Mikekim67/kicad/bp6a_evk_shield/bp6a_evk_shield.kicad_sch

## KiCad design bp6a_evk_shield/bp6a_evk_shield.kicad_sch (2025-01-07)

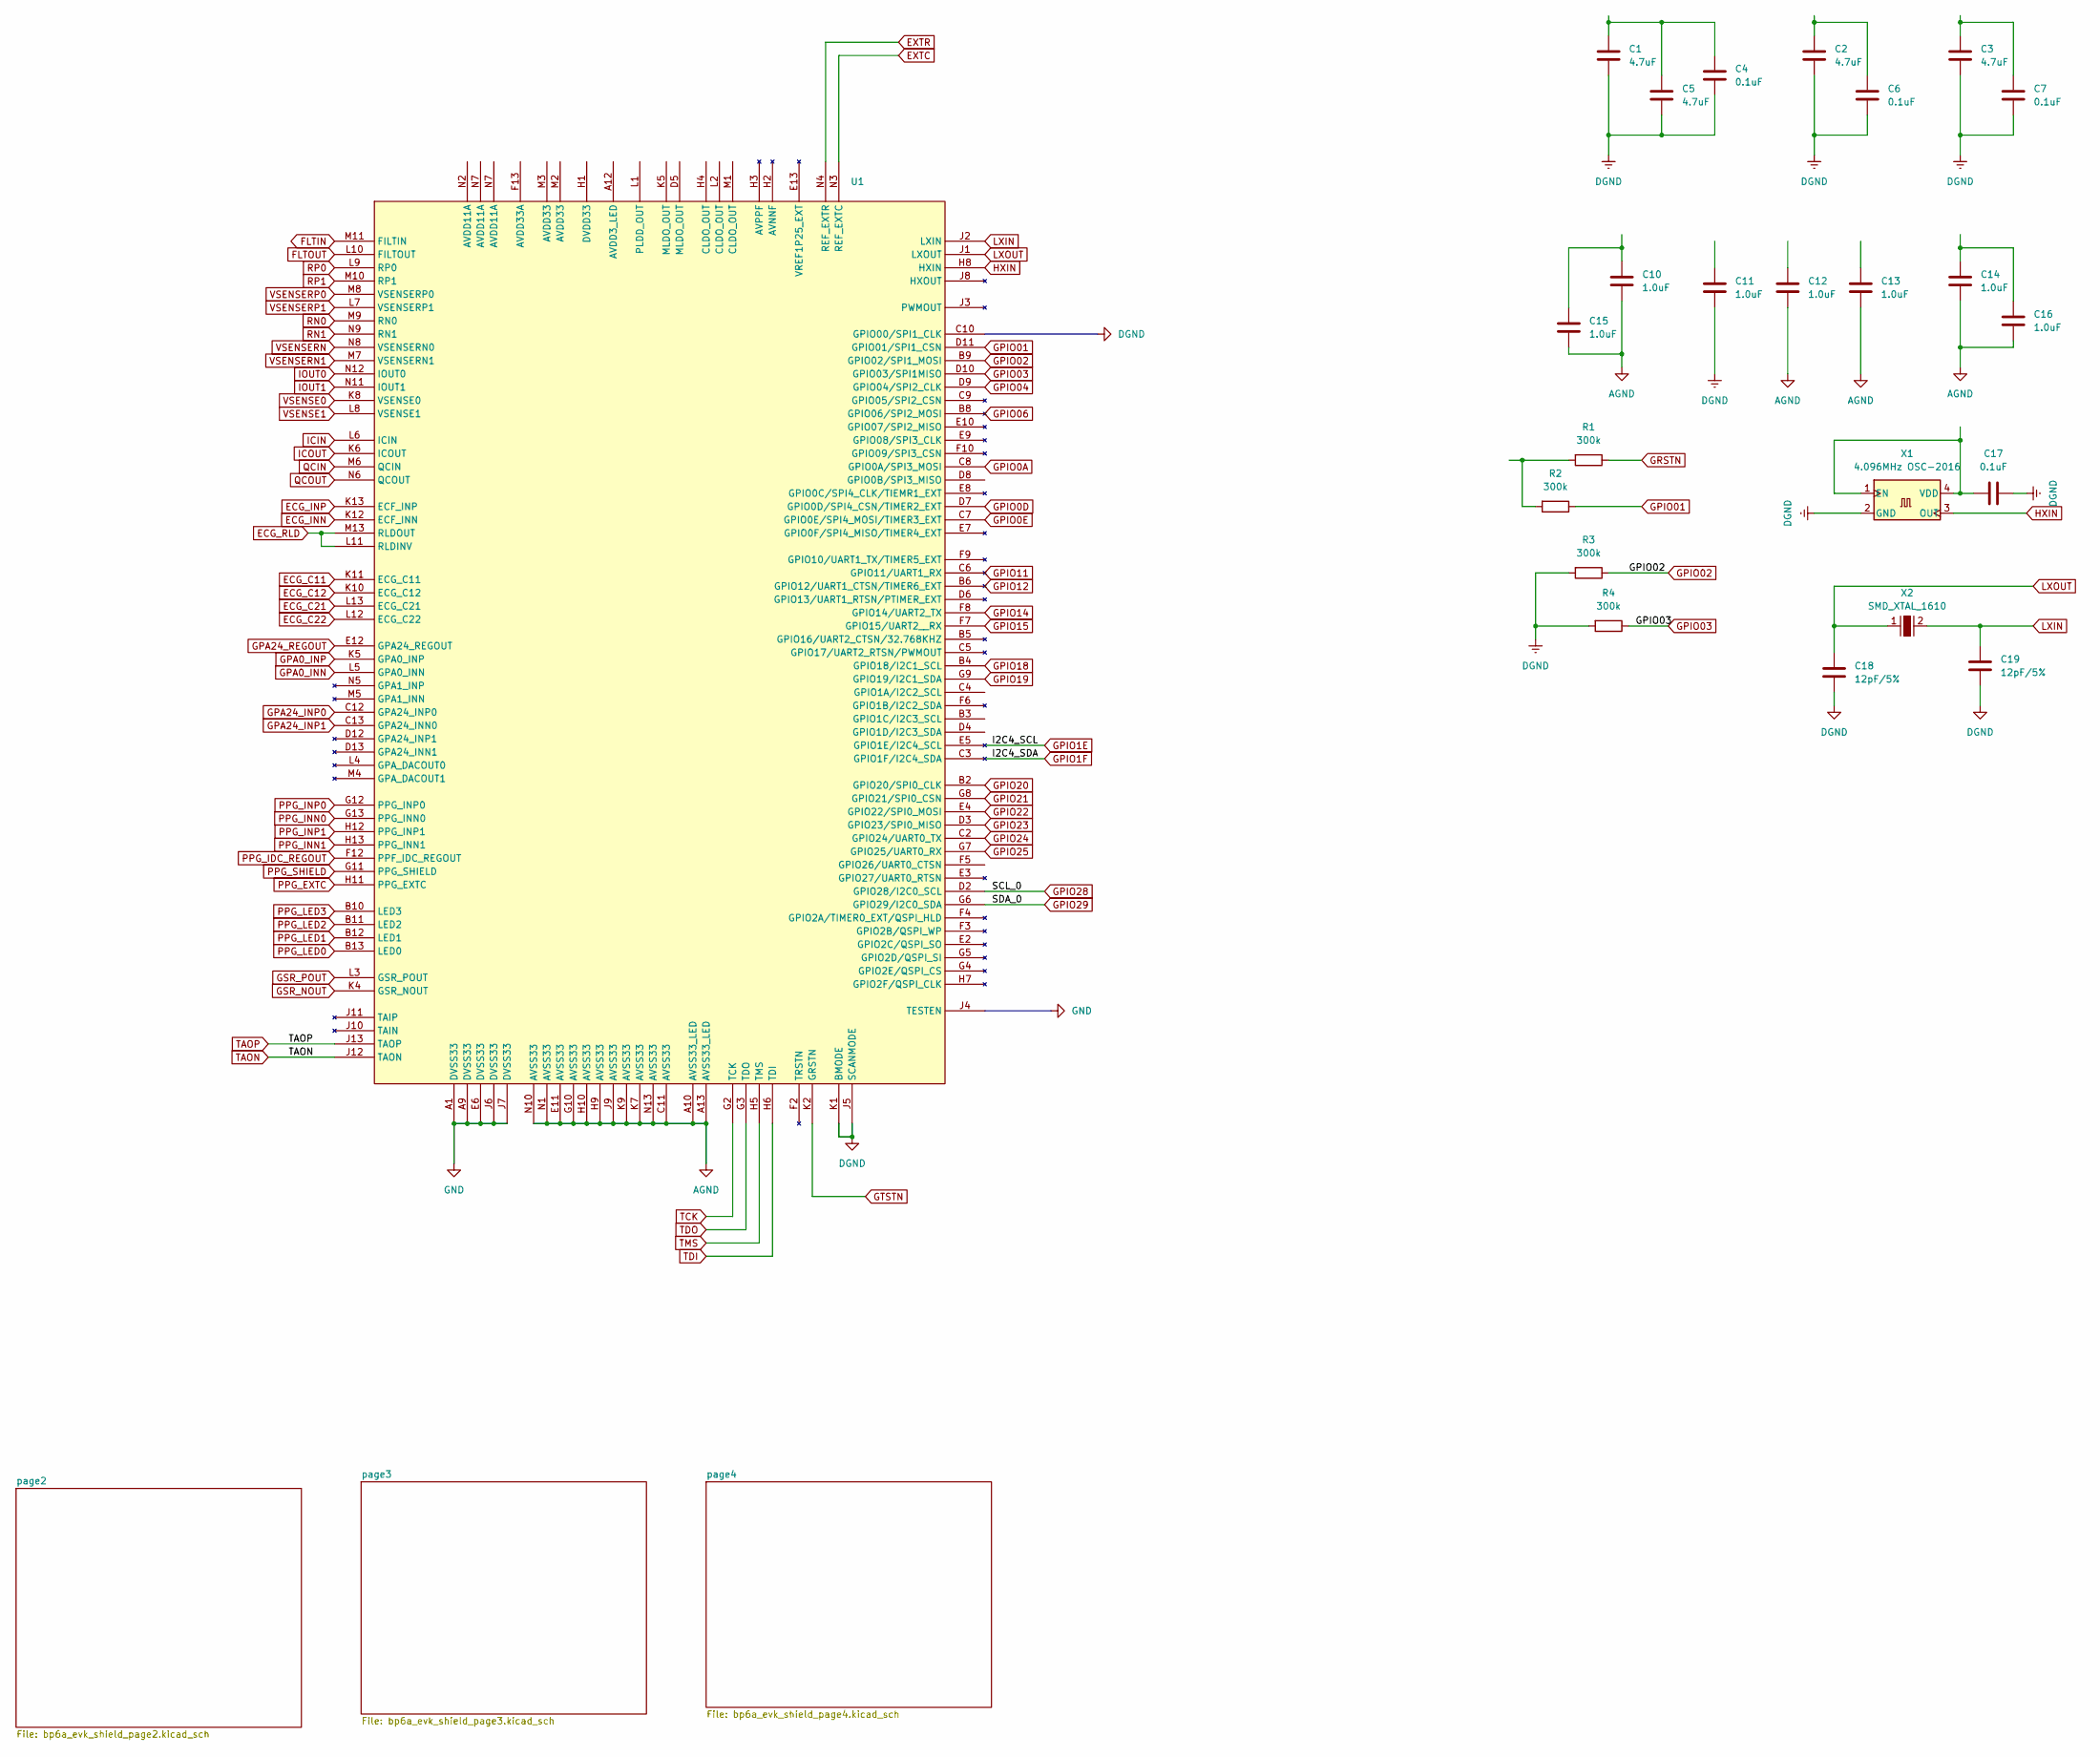
[picture p7: schematic bp6a_evk_shield.kicad_sch]

Parts:
C1, C2, C3, C5: 4.7uF
C4, C6, C7, C17: 0.1uF
C10, C11, C12, C13, C14, C15, C16: 1.0uF
C18, C19: 12pF/5%
R1, R2, R3, R4: 300k
U1: (no value)
X1: 4.096MHz OSC-2016; Oscillator_SMD_Abracon_ASE-4Pin_3.2x2.5mm
X2: SMD_XTAL_1610; SMD-2_3.2x1.5mm; MPN ECS-.327-12.5-34B-TR; Digi-Key_PN XC1617CT-ND

Connections:
AGND: C10.2, C12.2, C13.2, C14.2, C15.2, C16.2, U1.A10 (AVSS33_LED), U1.A13 (AVSS33_LED), U1.C11 (AVSS33), U1.E11 (AVSS33), U1.G10 (AVSS33), U1.H9 (AVSS33), U1.H10 (AVSS33), U1.J9 (AVSS33), U1.K7 (AVSS33), U1.K9 (AVSS33), U1.N1 (AVSS33), U1.N10 (AVSS33), U1.N13 (AVSS33)
DGND: C1.2, C2.2, C3.2, C4.2, C5.2, C6.2, C7.2, C11.2, C17.2, C18.2, C19.2, R3.2, R4.2, U1.J5 (SCANMODE), U1.K1 (BMODE), X1.2 (GND)
ECG_C11: U1.K11 (ECG_C11)
ECG_C12: U1.K10 (ECG_C12)
ECG_C21: U1.L13 (ECG_C21)
ECG_C22: U1.L12 (ECG_C22)
ECG_INN: U1.K12 (ECF_INN)
ECG_INP: U1.K13 (ECF_INP)
ECG_RLD: U1.L11 (RLDINV), U1.M13 (RLDOUT)
EXTC: U1.N3 (REF_EXTC)
EXTR: U1.N4 (REF_EXTR)
FLTIN: U1.M11 (FILTIN)
FLTOUT: U1.L10 (FILTOUT)
GND: U1.A1 (DVSS33), U1.A9 (DVSS33), U1.E6 (DVSS33), U1.J6 (DVSS33), U1.J7 (DVSS33)
GPA0_INN: U1.L5 (GPA0_INN)
GPA0_INP: U1.K5 (GPA0_INP)
GPA24_INP0: U1.C12 (GPA24_INP0)
GPA24_INP1: U1.C13 (GPA24_INN0)
GPA24_REGOUT: U1.E12 (GPA24_REGOUT)
GPIO0A: U1.C8 (GPIO0A/SPI3_MOSI)
GPIO0D: U1.D7 (GPIO0D/SPI4_CSN/TIMER2_EXT)
GPIO0E: U1.C7 (GPIO0E/SPI4_MOSI/TIMER3_EXT)
GPIO01: R2.1, U1.D11 (GPIO01/SPI1_CSN)
GPIO1E: U1.E5 (GPIO1E/I2C4_SCL)
GPIO1F: U1.C3 (GPIO1F/I2C4_SDA)
GPIO02: R3.1, U1.B9 (GPIO02/SPI1_MOSI)
GPIO03: R4.1, U1.D10 (GPIO03/SPI1MISO)
GPIO04: U1.D9 (GPIO04/SPI2_CLK)
GPIO06: U1.B8 (GPIO06/SPI2_MOSI)
GPIO11: U1.C6 (GPIO11/UART1_RX)
GPIO12: U1.B6 (GPIO12/UART1_CTSN/TIMER6_EXT)
GPIO14: U1.F8 (GPIO14/UART2_TX)
GPIO15: U1.F7 (GPIO15/UART2__RX)
GPIO18: U1.B4 (GPIO18/I2C1_SCL)
GPIO19: U1.G9 (GPIO19/I2C1_SDA)
GPIO20: U1.B2 (GPIO20/SPI0_CLK)
GPIO21: U1.G8 (GPIO21/SPI0_CSN)
GPIO22: U1.E4 (GPIO22/SPI0_MOSI)
GPIO23: U1.D3 (GPIO23/SPI0_MISO)
GPIO24: U1.C2 (GPIO24/UART0_TX)
GPIO25: U1.G7 (GPIO25/UART0_RX)
GPIO28: U1.D2 (GPIO28/I2C0_SCL)
GPIO29: U1.G6 (GPIO29/I2C0_SDA)
GRSTN: R1.1
GSR_NOUT: U1.K4 (GSR_NOUT)
GSR_POUT: U1.L3 (GSR_POUT)
GTSTN: U1.K2 (GRSTN)
HXIN: U1.H8 (HXIN), X1.3 (OUT)
ICIN: U1.L6 (ICIN)
ICOUT: U1.K6 (ICOUT)
IOUT0: U1.N12 (IOUT0)
IOUT1: U1.N11 (IOUT1)
LXIN: C19.1, U1.J2 (LXIN), X2.2
LXOUT: C18.1, U1.J1 (LXOUT), X2.1
unnamed: C1.1, C4.1, C5.1
unnamed: C2.1, C6.1
unnamed: C3.1, C7.1
unnamed: C10.1, C15.1
unnamed: C14.1, C16.1
unnamed: C17.1, X1.1 (EN), X1.4 (VDD)
unnamed: R1.2, R2.2
PPG_EXTC: U1.H11 (PPG_EXTC)
PPG_IDC_REGOUT: U1.F12 (PPF_IDC_REGOUT)
PPG_INN0: U1.G13 (PPG_INN0)
PPG_INN1: U1.H13 (PPG_INN1)
PPG_INP0: U1.G12 (PPG_INP0)
PPG_INP1: U1.H12 (PPG_INP1)
PPG_LED0: U1.B13 (LED0)
PPG_LED1: U1.B12 (LED1)
PPG_LED2: U1.B11 (LED2)
PPG_LED3: U1.B10 (LED3)
PPG_SHIELD: U1.G11 (PPG_SHIELD)
QCIN: U1.M6 (QCIN)
QCOUT: U1.N6 (QCOUT)
RN0: U1.M9 (RN0)
RN1: U1.N9 (RN1)
RP0: U1.L9 (RP0)
RP1: U1.M10 (RP1)
TAON: U1.J12 (TAON)
TAOP: U1.J13 (TAOP)
TCK: U1.G2 (TCK)
TDI: U1.H6 (TDI)
TDO: U1.G3 (TDO)
TMS: U1.H5 (TMS)
VSENSE0: U1.K8 (VSENSE0)
VSENSE1: U1.L8 (VSENSE1)
VSENSERN: U1.N8 (VSENSERN0)
VSENSERN1: U1.M7 (VSENSERN1)
VSENSERP0: U1.M8 (VSENSERP0)
VSENSERP1: U1.L7 (VSENSERP1)
