Mikekim67/kicad/bp6a_evk_shield/bp6a_evk_shield_page2.kicad_sch

## KiCad design bp6a_evk_shield/bp6a_evk_shield_page2.kicad_sch (2025-01-07)

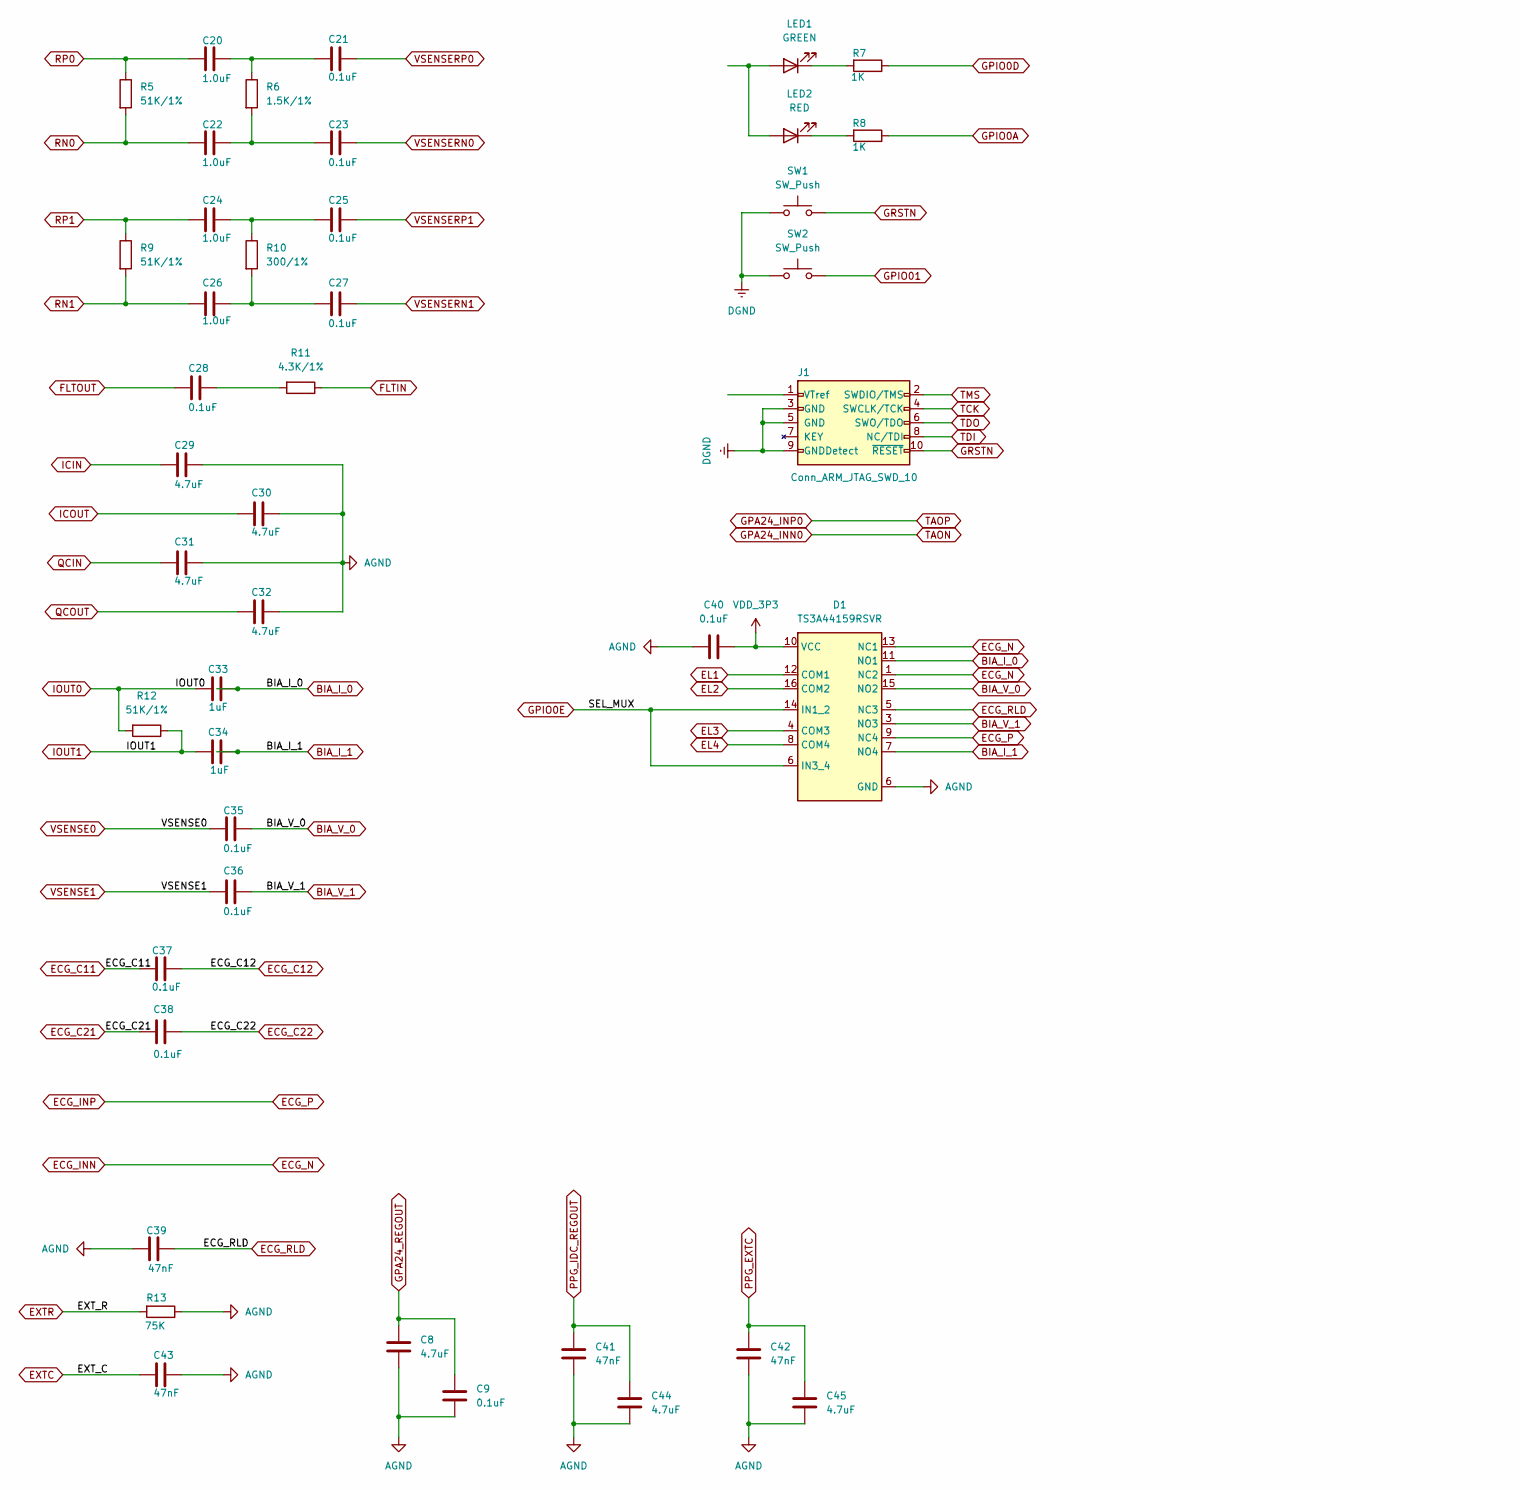
[picture p8: schematic bp6a_evk_shield_page2.kicad_sch, part in row 1, column 1]

Parts:
C8, C29, C30, C31, C32, C44, C45: 4.7uF
C9, C21, C23, C25, C27, C28, C35, C36, C37, C38, C40: 0.1uF
C20, C22, C24, C26: 1.0uF
C33, C34: 1uF
C39, C41, C42, C43: 47nF
D1: TS3A44159RSVR; TS3A44159RSVR_UQFN-16
J1: Conn_ARM_JTAG_SWD_10; JTAG_10PinHeader_2x05_P1.27mm_Vertical
LED1: GREEN
LED2: RED
R5, R9, R12: 51K/1%
R6: 1.5K/1%
R7, R8: 1K
R10: 300/1%
R11: 4.3K/1%
R13: 75K
SW1, SW2: SW_Push

Connections:
AGND: C8.2, C9.2, C29.2, C30.2, C31.2, C32.2, C39.1, C40.1, C41.2, C42.2, C43.2, C44.2, C45.2, D1.6 (GND), R13.1
BIA_I_0: C33.2, D1.11 (NO1)
BIA_I_1: C34.2, D1.7 (NO4)
BIA_V_0: C35.2, D1.15 (NO2)
BIA_V_1: C36.2, D1.3 (NO3)
DGND: J1.3 (GND), J1.5 (GND), J1.9 (GNDDetect), SW1.1, SW2.1
ECG_C11: C37.1
ECG_C12: C37.2
ECG_C21: C38.1
ECG_C22: C38.2
ECG_INN: D1.1 (NC2), D1.13 (NC1)
ECG_INP: D1.9 (NC4)
ECG_RLD: C39.2, D1.5 (NC3)
EL1: D1.12 (COM1)
EL2: D1.16 (COM2)
EL3: D1.4 (COM3)
EL4: D1.8 (COM4)
EXTC: C43.1
EXTR: R13.2
FLTIN: R11.1
FLTOUT: C28.1
GPA24_REGOUT: C8.1, C9.1
GPIO0A: R8.1
GPIO0D: R7.1
GPIO0E: D1.6 (GND), D1.14 (IN1_2)
GPIO01: SW2.2
GRSTN: J1.10 (~RESET), SW1.2
ICIN: C29.1
ICOUT: C30.1
IOUT0: C33.1, R12.2
IOUT1: C34.1, R12.1
unnamed: C20.2, C21.1, R6.1
unnamed: C22.2, C23.1, R6.2
unnamed: C24.2, C25.1, R10.1
unnamed: C26.2, C27.1, R10.2
unnamed: C28.2, R11.2
unnamed: LED1.1 (K), R7.2
unnamed: LED1.2 (A), LED2.2 (A)
unnamed: LED2.1 (K), R8.2
PPG_EXTC: C42.1, C45.1
PPG_IDC_REGOUT: C41.1, C44.1
QCIN: C31.1
QCOUT: C32.1
RN0: C22.1, R5.2
RN1: C26.1, R9.2
RP0: C20.1, R5.1
RP1: C24.1, R9.1
TCK: J1.4 (SWCLK/TCK)
TDI: J1.8 (NC/TDI)
TDO: J1.6 (SWO/TDO)
TMS: J1.2 (SWDIO/TMS)
VDD_3P3: C40.2, D1.10 (VCC)
VSENSE0: C35.1
VSENSE1: C36.1
VSENSERN0: C23.2
VSENSERN1: C27.2
VSENSERP0: C21.2
VSENSERP1: C25.2
