Mikekim67/kicad/bp6a_evk_shield/bp6a_evk_shield_page3.kicad_sch

## KiCad design bp6a_evk_shield/bp6a_evk_shield_page3.kicad_sch (2025-01-13)

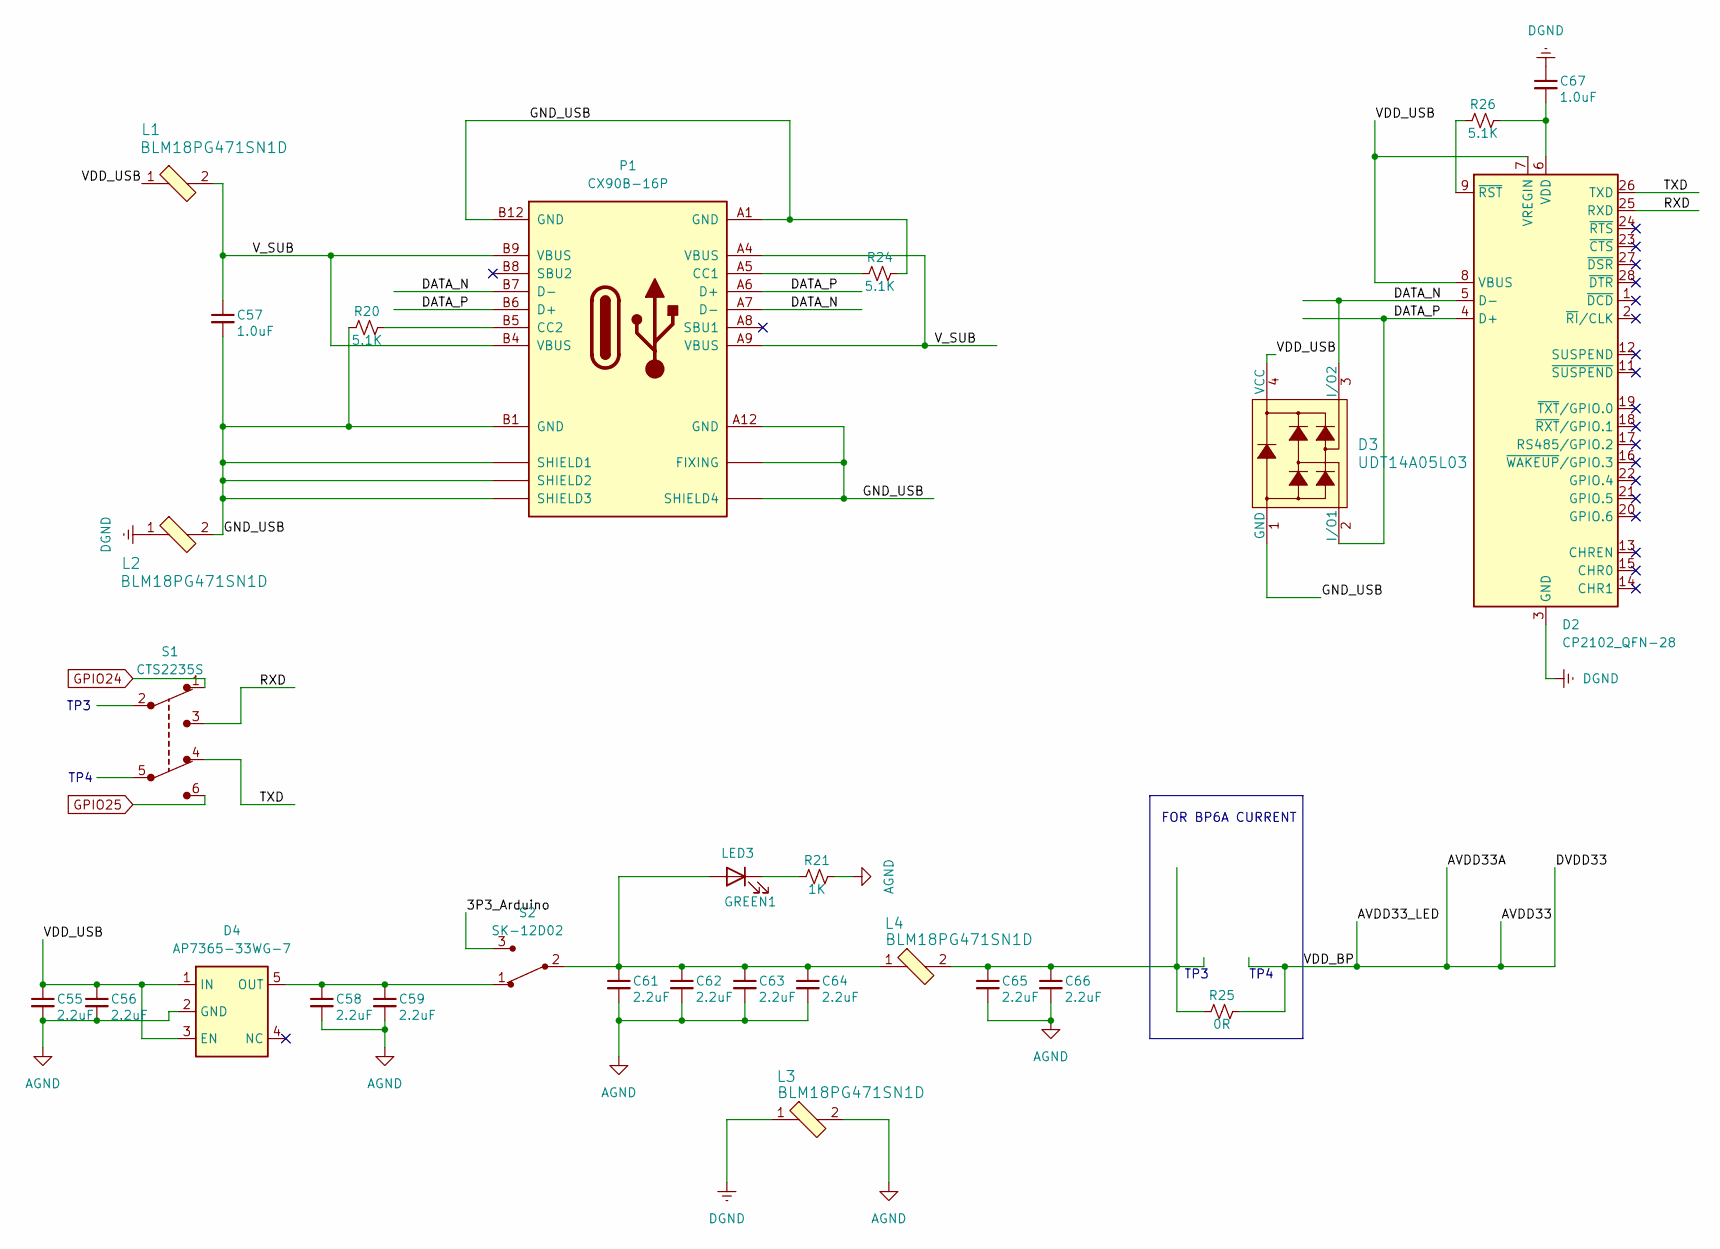
[picture p9: schematic bp6a_evk_shield_page3.kicad_sch]

Parts:
C55, C56, C58, C59, C61, C62, C63, C64, C65, C66: 2.2uF
C57, C67: 1.0uF
D2: CP2102_QFN-28
D3: UDT14A05L03
D4: AP7365-33WG-7
GREEN1: LED3
L1, L2, L3, L4: BLM18PG471SN1D; 0603; MPN BLM18PG471SN1D; Digi-Key_PN 490-5223-1-ND
P1: CX90B-16P
R20, R24, R26: 5.1K
R21: 1K
R25: 0R
S1: CTS2235S
S2: SK-12D02

Connections:
3P3_Arduino: S2.3
AGND: C55.2, C56.2, C58.2, C59.2, C61.2, C62.2, C63.2, C64.2, C65.2, C66.2, D4.2 (GND), L3.2, R21.2
AVDD33: R25.2
DATA_N: D2.5 (D-), D3.3 (I/O2), P1.A7 (D-), P1.B7 (D-)
DATA_P: D2.4 (D+), D3.2 (I/O1), P1.A6 (D+), P1.B6 (D+)
DGND: C67.1, D2.3 (GND), D2.29 (GND), L2.1, L3.1
GND_USB: C57.2, D3.1 (GND), L2.2, P1. (FIXING), P1.A1 (GND), P1.A12 (GND), P1.B1 (GND), P1.B12 (GND), R20.1, R24.2
GPIO24: S1.1
GPIO25: S1.6
unnamed: C58.1, C59.1, D4.5 (OUT), S2.1
unnamed: C61.1, C62.1, C63.1, C64.1, GREEN1.2 (A), L4.1, S2.2
unnamed: C65.1, C66.1, L4.2, R25.1
unnamed: C67.2, D2.6 (VDD), R26.2
unnamed: D2.9 (~RST), R26.1
unnamed: GREEN1.1 (K), R21.1
unnamed: P1.A5 (CC1), R24.1
unnamed: P1.B5 (CC2), R20.2
RXD: D2.25 (RXD), S1.3
TXD: D2.26 (TXD), S1.4
VDD_USB: C55.1, C56.1, D2.7 (VREGIN), D2.8 (VBUS), D3.4 (VCC), D4.1 (IN), D4.3 (EN), L1.1
V_SUB: C57.1, L1.2, P1.A4 (VBUS), P1.A9 (VBUS), P1.B4 (VBUS), P1.B9 (VBUS)

Notes on the sheet:
TP4
TP3
FOR BP6A CURRENT
