Mikekim67/kicad/bp6a_evk_shield/bp6a_evk_shield_page4.kicad_sch

## KiCad design bp6a_evk_shield/bp6a_evk_shield_page4.kicad_sch (2025-01-13)

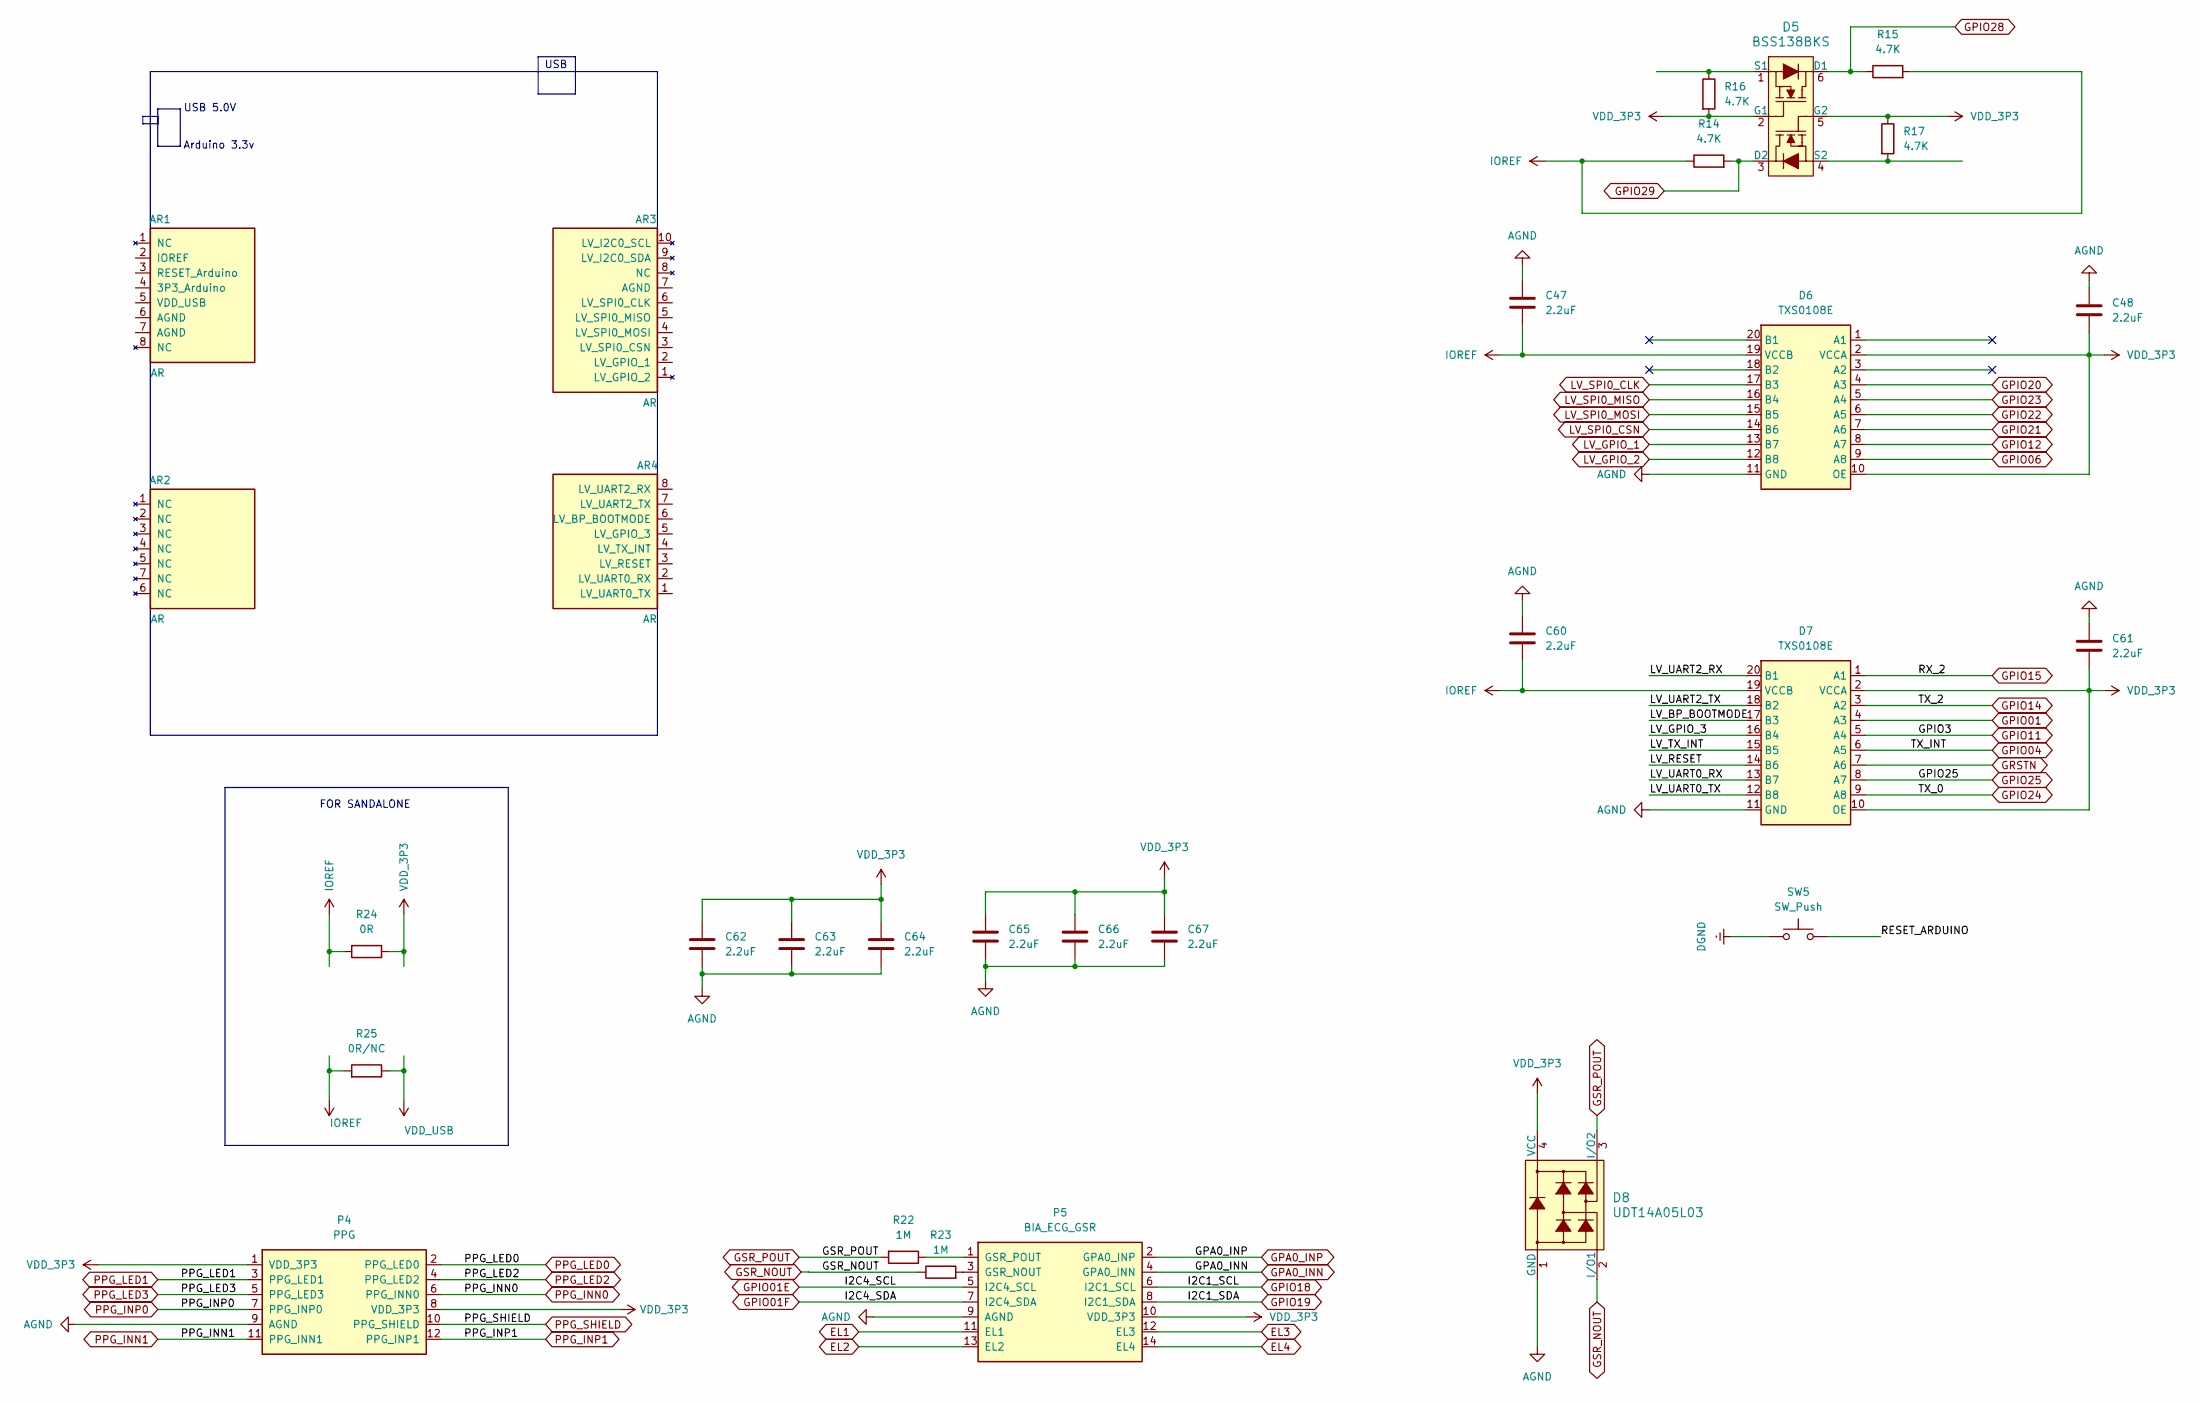
[picture p10: schematic bp6a_evk_shield_page4.kicad_sch]

Parts:
AR1, AR2, AR3, AR4: AR
C47, C48, C60, C61, C62, C63, C64, C65, C66, C67: 2.2uF
D5: BSS138BKS
D6, D7: TXS0108E
D8: UDT14A05L03
P4: PPG
P5: BIA_ECG_GSR
R14, R15, R16, R17: 4.7K
R22, R23: 1M
R24: 0R
R25: 0R/NC
SW5: SW_Push

Connections:
AGND: C47.1, C48.1, C60.1, C61.1, C62.2, C63.2, C64.2, C65.2, C66.2, C67.2, D6.11 (GND), D7.11 (GND), D8.1 (GND), P4.9 (AGND), P5.9 (AGND)
DGND: SW5.1
EL1: P5.11 (EL1)
EL2: P5.13 (EL2)
EL3: P5.12 (EL3)
EL4: P5.14 (EL4)
GPA0_INN: P5.4 (GPA0_INN)
GPA0_INP: P5.2 (GPA0_INP)
GPIO01: D7.4 (A3)
GPIO01E: P5.5 (I2C4_SCL)
GPIO01F: P5.7 (I2C4_SDA)
GPIO04: D7.6 (A5)
GPIO06: D6.9 (A8)
GPIO11: D7.5 (A4)
GPIO12: D6.8 (A7)
GPIO14: D7.3 (A2)
GPIO15: D7.1 (A1)
GPIO18: P5.6 (I2C1_SCL)
GPIO19: P5.8 (I2C1_SDA)
GPIO20: D6.4 (A3)
GPIO21: D6.7 (A6)
GPIO22: D6.6 (A5)
GPIO23: D6.5 (A4)
GPIO24: D7.9 (A8)
GPIO25: D7.8 (A7)
GPIO28: D5.6 (D1), R15.1
GPIO29: D5.3 (D2), R14.2
GRSTN: D7.7 (A6)
GSR_NOUT: D8.2 (I/O1), R23.1
GSR_POUT: D8.3 (I/O2), R22.2
IOREF: C47.2, C60.2, D6.19 (VCCB), D7.19 (VCCB), R14.1, R15.2, R24.2, R25.2
LV_BP_BOOTMODE: D7.17 (B3)
LV_GPIO_1: D6.13 (B7)
LV_GPIO_2: D6.12 (B8)
LV_GPIO_3: D7.16 (B4)
LV_RESET: D7.14 (B6)
LV_SPI0_CLK: D6.17 (B3)
LV_SPI0_CSN: D6.14 (B6)
LV_SPI0_MISO: D6.16 (B4)
LV_SPI0_MOSI: D6.15 (B5)
LV_TX_INT: D7.15 (B5)
LV_UART0_RX: D7.13 (B7)
LV_UART0_TX: D7.12 (B8)
LV_UART2_RX: D7.20 (B1)
LV_UART2_TX: D7.18 (B2)
unnamed: D5.1 (S1), R16.1
unnamed: D5.4 (S2), R17.2
unnamed: P5.1 (GSR_POUT), R22.1
unnamed: P5.3 (GSR_NOUT), R23.2
PPG_INN0: P4.6 (PPG_INN0)
PPG_INN1: P4.11 (PPG_INN1)
PPG_INP0: P4.7 (PPG_INP0)
PPG_INP1: P4.12 (PPG_INP1)
PPG_LED0: P4.2 (PPG_LED0)
PPG_LED1: P4.3 (PPG_LED1)
PPG_LED2: P4.4 (PPG_LED2)
PPG_LED3: P4.5 (PPG_LED3)
PPG_SHIELD: P4.10 (PPG_SHIELD)
RESET_ARDUINO: SW5.2
VDD_3P3: C48.2, C61.2, C62.1, C63.1, C64.1, C65.1, C66.1, C67.1, D5.2 (G1), D5.5 (G2), D6.2 (VCCA), D6.10 (OE), D7.2 (VCCA), D7.10 (OE), D8.4 (VCC), P4.1 (VDD_3P3), P4.8 (VDD_3P3), P5.10 (VDD_3P3), R16.2, R17.1, R24.1
VDD_USB: R25.1

Notes on the sheet:
USB
FOR SANDALONE
USB 5.0V
Arduino 3.3v
