Mikekim67/kicad/(commit log)

2025-01-07 2025/01/07 PM 11:00
    [bp6a_evk_shield.kicad_sch, bp6a_evk_shield_page2.kicad_sch, bp6a_evk_shield_page3.kicad_sch, bp6a_evk_shield_page4.kicad_sch]
2025-01-13 2025-01-13 PM03:16
    [bp6a_evk_shield.kicad_sch, bp6a_evk_shield_page2.kicad_sch, bp6a_evk_shield_page3.kicad_sch, bp6a_evk_shield_page4.kicad_sch]
